sowd/ZyuohPhone/imgs/0.jpg

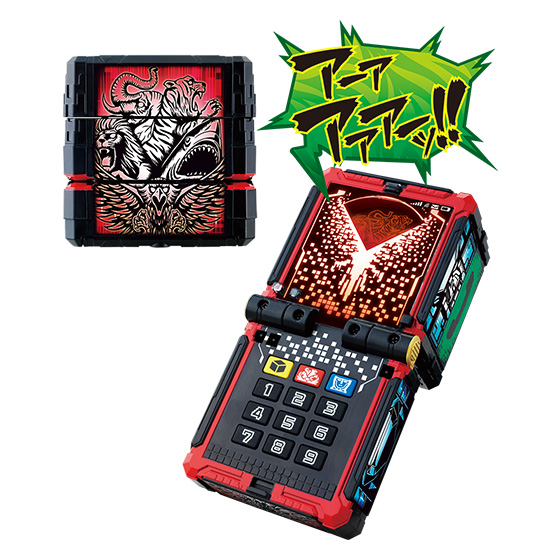
imgs/0.jpg
